root50643/DEM510C/Image/CardReader/6P6C.jpg

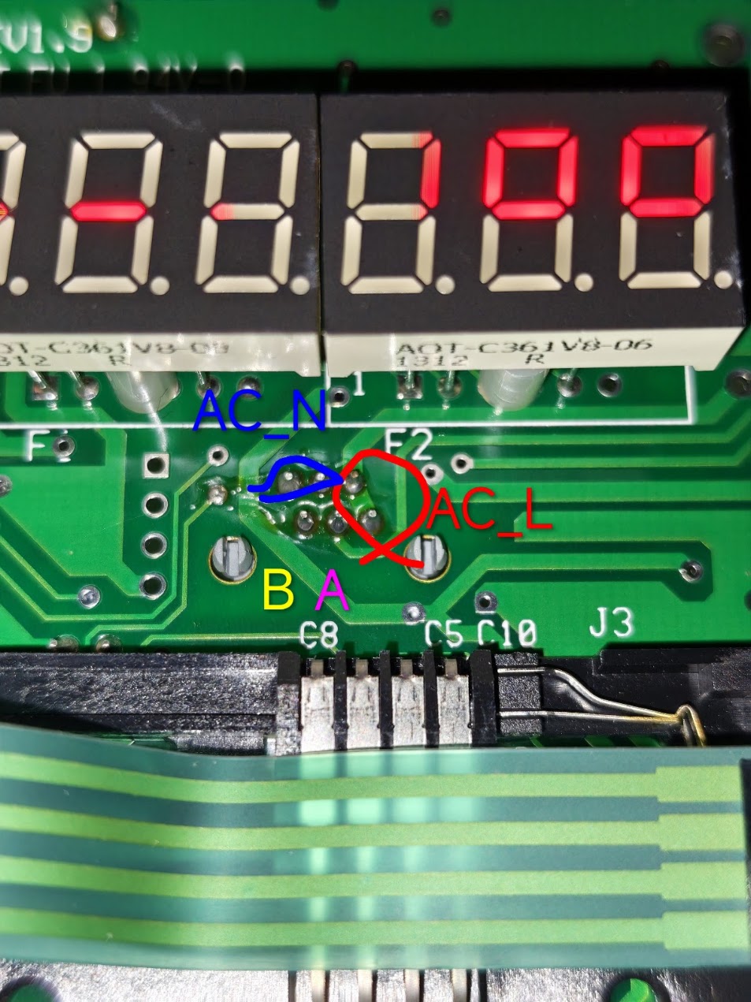
Image/CardReader/6P6C.jpg
