root50643/DEM510C/Image/CardReader/back.jpg

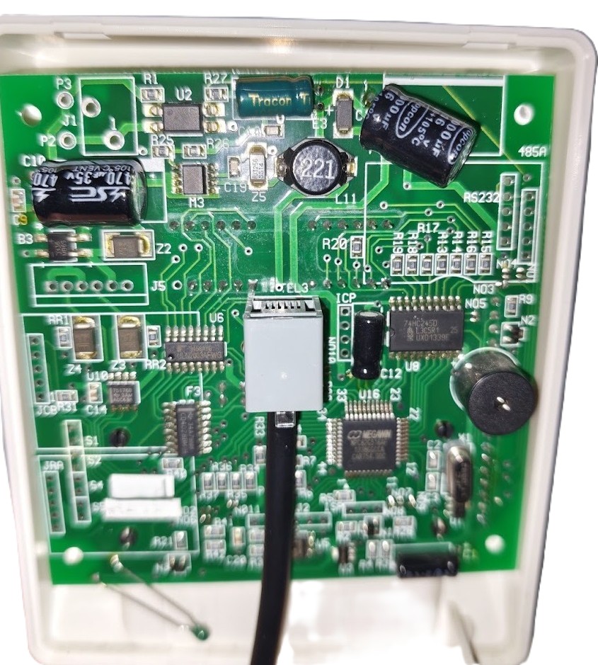
Image/CardReader/back.jpg
