root50643/DEM510C/Image/CardReader/CD4028BM.jpg

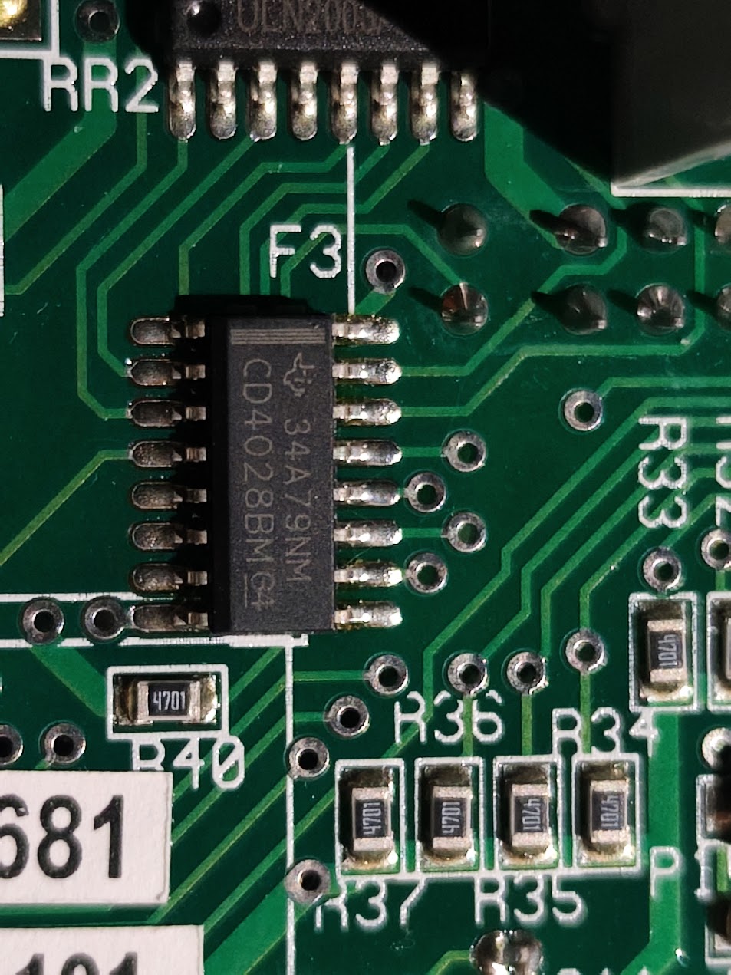
Image/CardReader/CD4028BM.jpg
