root50643/DEM510C/Image/CardReader/front.jpg

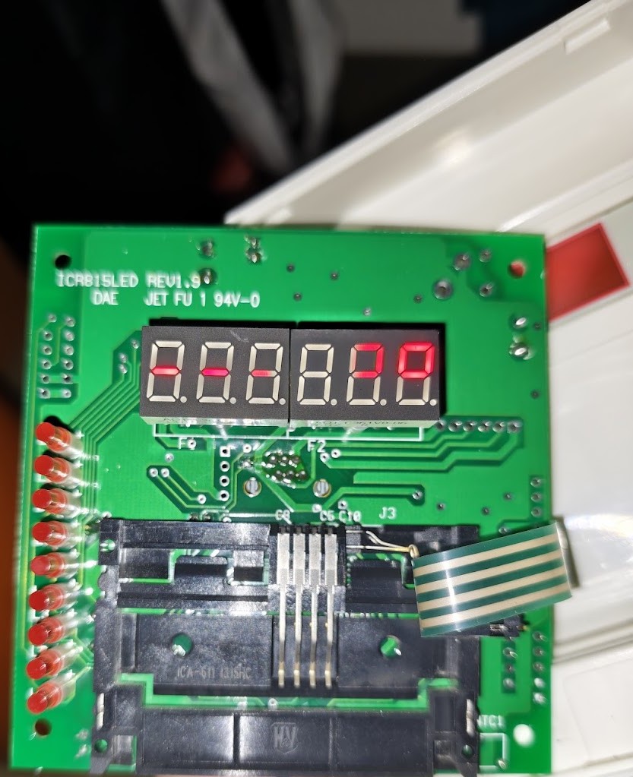
Image/CardReader/front.jpg
