root50643/DEM510C/Image/CardReader/MC34063AC.jpg

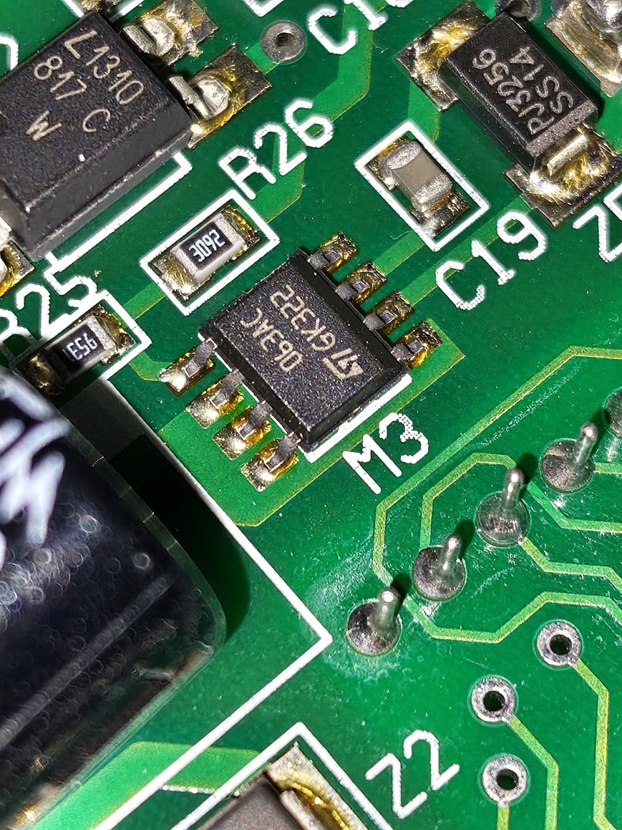
Image/CardReader/MC34063AC.jpg
