root50643/DEM510C/Image/CardReader/MPC82G516AF.jpg

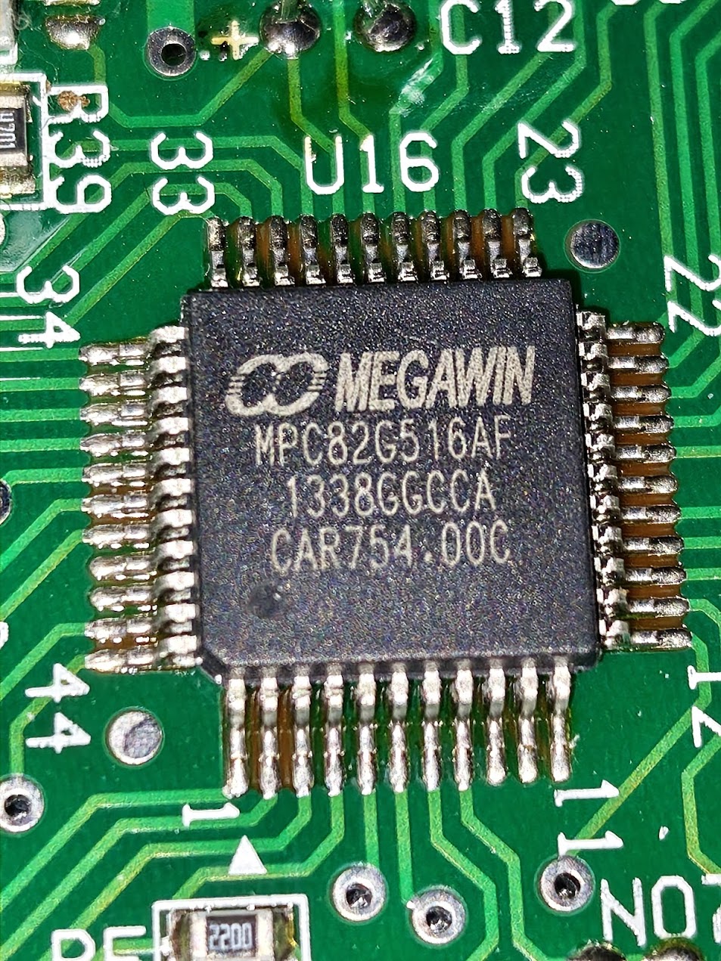
Image/CardReader/MPC82G516AF.jpg
