root50643/DEM510C/Image/CardReader/SN75176B.jpg

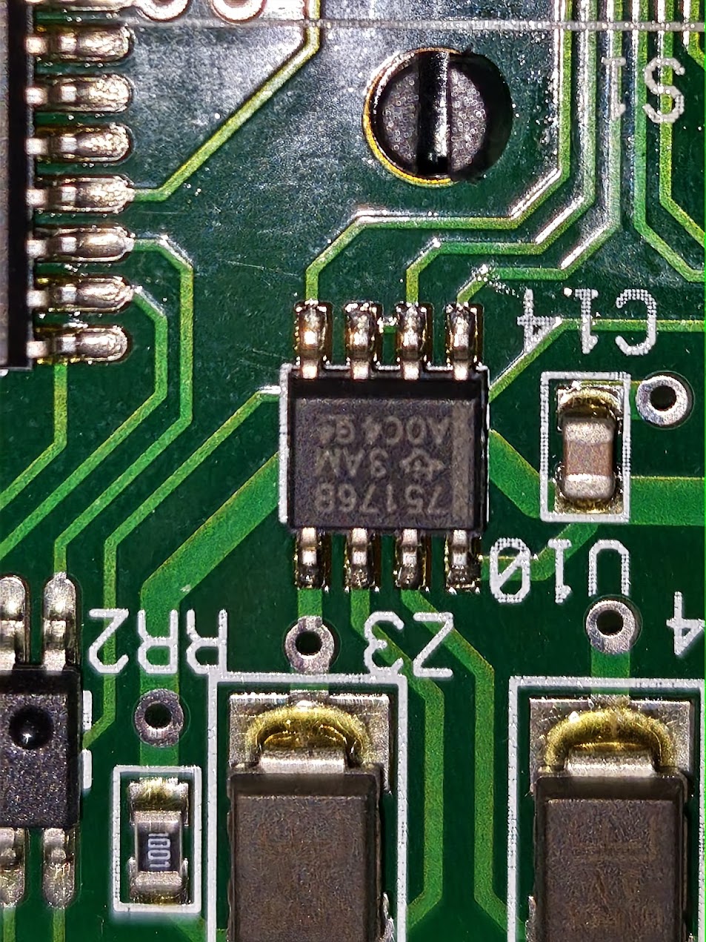
Image/CardReader/SN75176B.jpg
