root50643/DEM510C/Image/CardReader/ULN2003AFWG.jpg

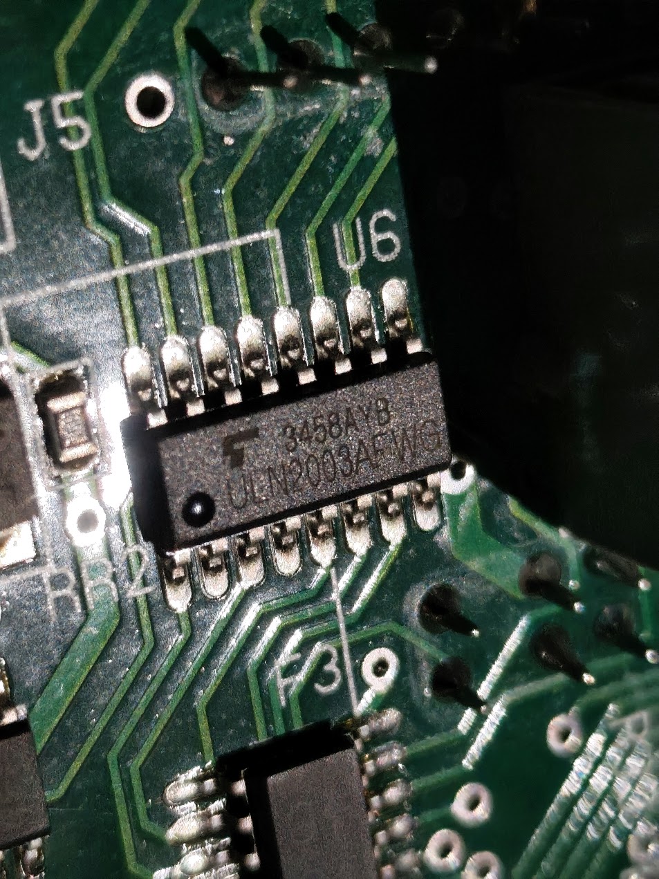
Image/CardReader/ULN2003AFWG.jpg
